cpmpercussion/EMS-DIYSynth/images/2-ControllingVolume_schem.png

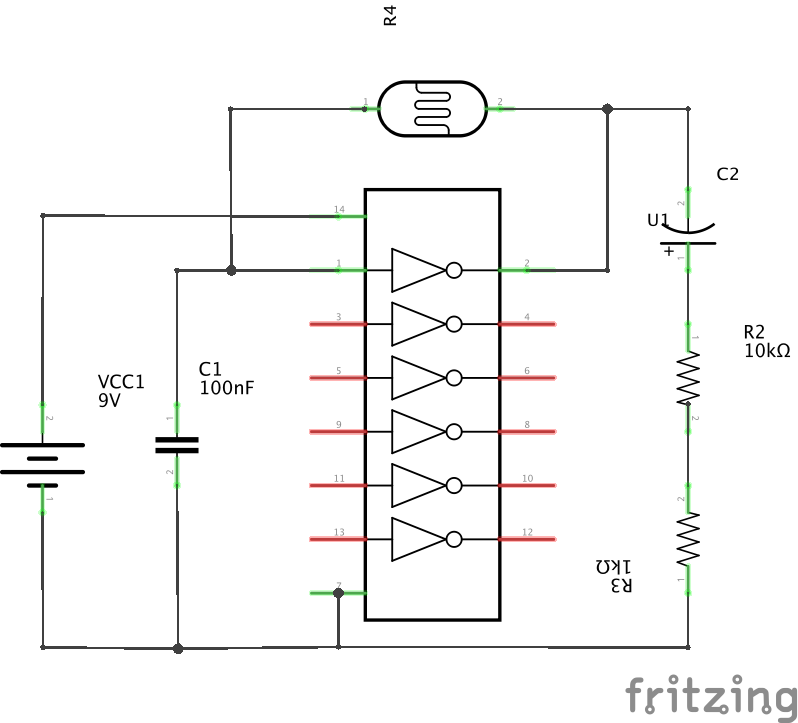
images/2-ControllingVolume_schem.png
