cpmpercussion/EMS-DIYSynth/images/3-ControllingPitch_schem.png

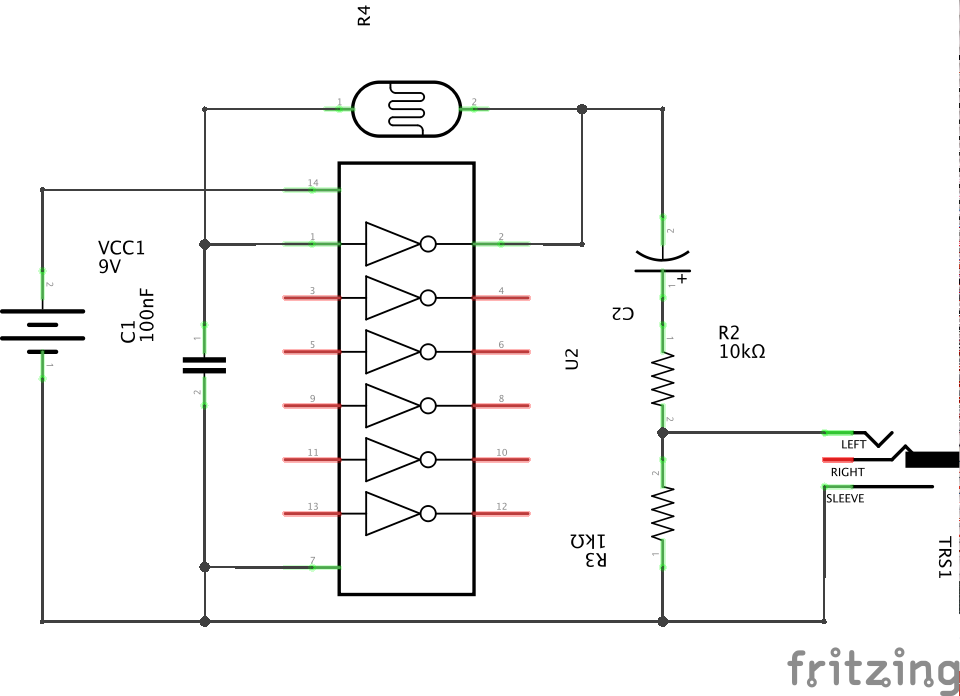
images/3-ControllingPitch_schem.png
