cpmpercussion/EMS-DIYSynth/images/circuit-example_bb.png

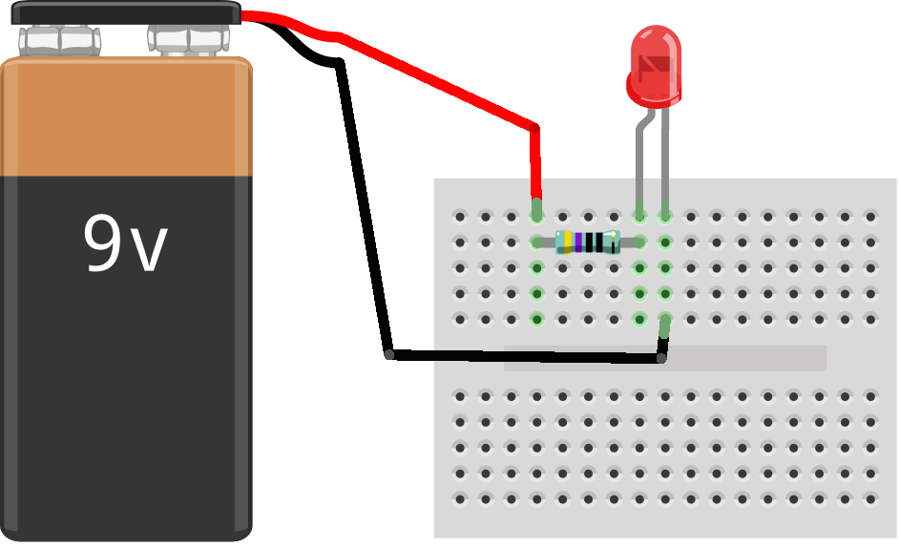
images/circuit-example_bb.png
