cpmpercussion/EMS-DIYSynth/images/circuit-example_schem.png

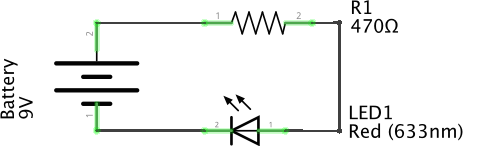
images/circuit-example_schem.png
