cpmpercussion/EMS-DIYSynth/images/1-MakingAnOscillator_schem.png

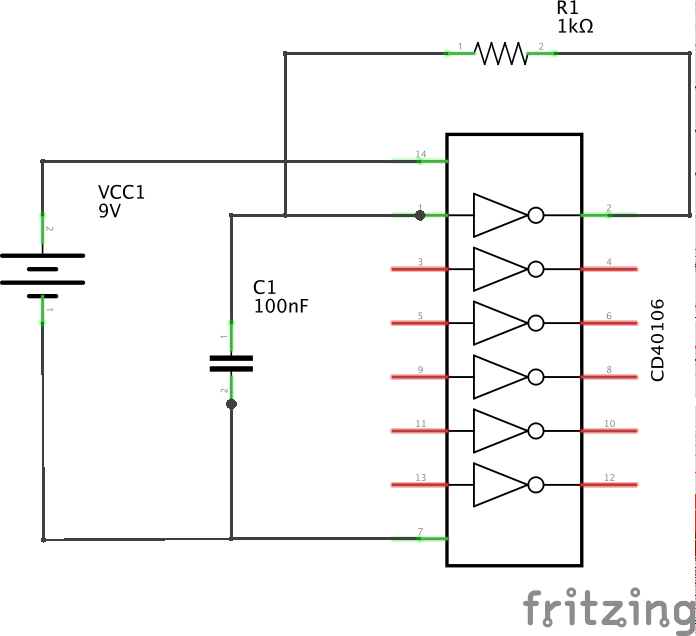
images/1-MakingAnOscillator_schem.png
