cpmpercussion/EMS-DIYSynth/(list of files, drawings)

Other design files:
0-SetupBreadboard.fzz
1-MakingAnOscillator.fzz
2-ControllingVolume.fzz
3-ControllingPitch.fzz
4-MixingTwoOscillators.fzz
5-NANDSynth.fzz
6-OscillatorsThatControlOscillators.fzz
circuit-example.fzz
passive-mixer.fzz
