cpmpercussion/EMS-DIYSynth/(commit log)

2015-07-06 draft circuit diagrams
    [0-SetupBreadboard.fzz, 1-MakingAnOscillator.fzz, 2-ControllingVolume.fzz, 3-ControllingPitch.fzz, 4-MixingTwoOscillators.fzz, 5-NANDSynth.fzz, 6-OscillatorsThatControlOscillators.fzz, passive-mixer.fzz]
2015-07-09 workshop version of worksheet
    [circuit-example.fzz]
2015-07-09 minor updates to the circuit files
    [1-MakingAnOscillator.fzz, 2-ControllingVolume.fzz, 3-ControllingPitch.fzz, 4-MixingTwoOscillators.fzz]
